ianm8/uSBITX/README.md

# uSBITX
An HF transceiver based on the sBITX.

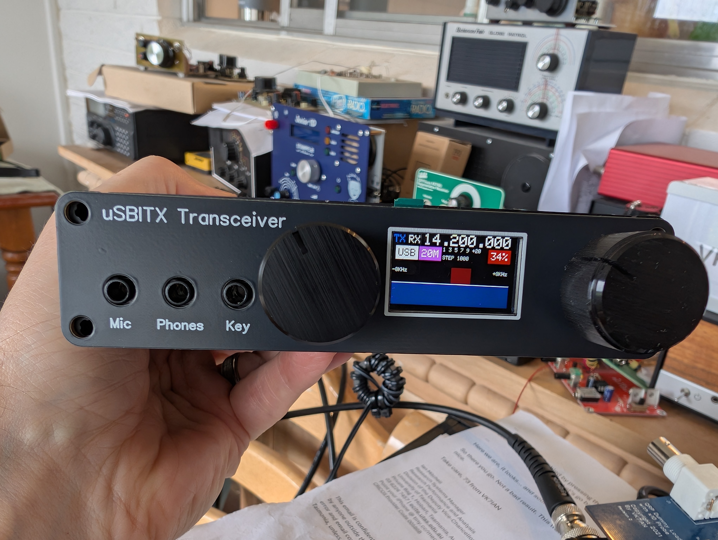
[picture p1: docs/uSBITX-Front.jpg]


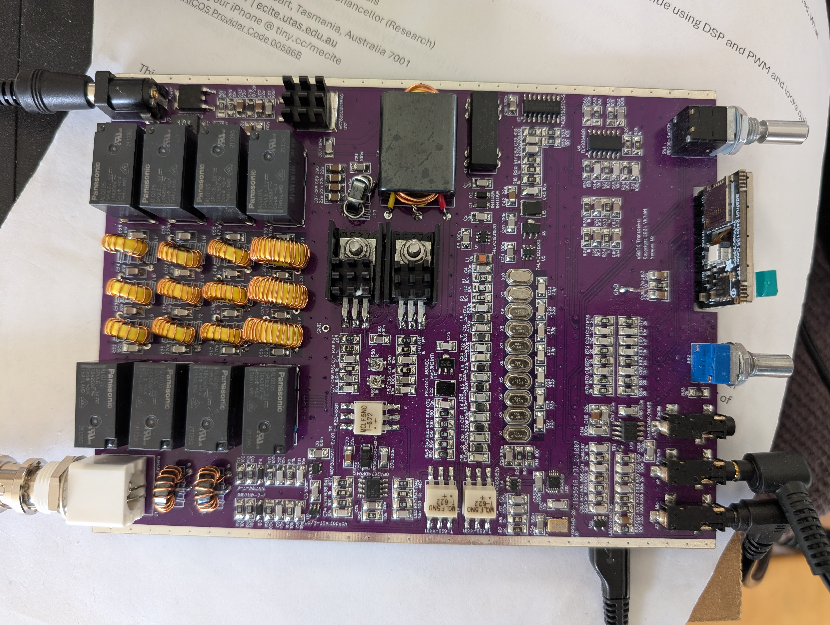
[picture p2: docs/uSBITX Complete.jpg]


Short video of a QSO between VK2IO and VK7AAE
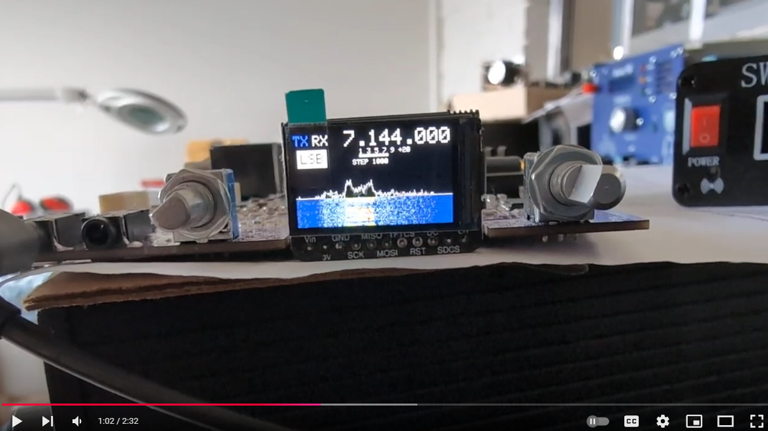
[picture p3: docs/QSO-Video.png]
IMAGE ALT TEXT HERE (https://www.youtube.com/watch?v=36nRCQEVp98&t=1s)


Short video of CW reception
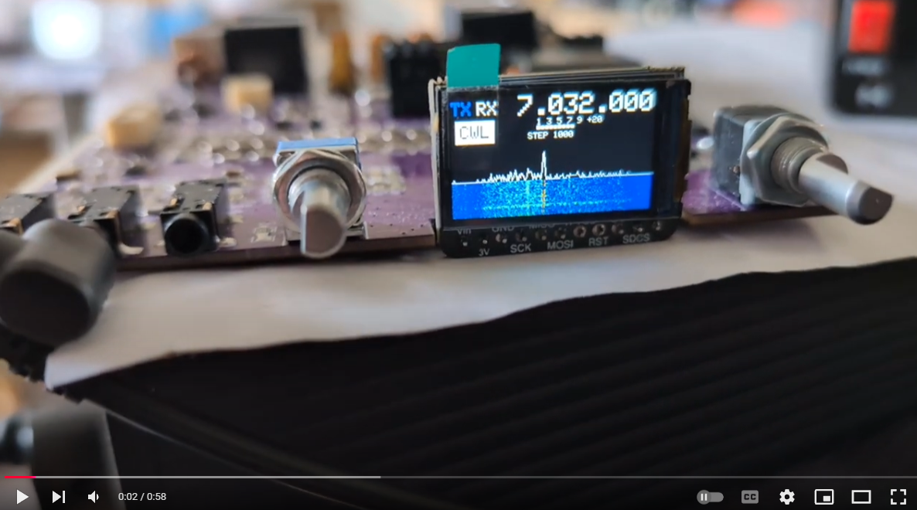
[picture p4: docs/CW-Video.png]
IMAGE ALT TEXT HERE (https://www.youtube.com/watch?v=rOs2oFVajr0)
