ianm8/uSBITX/docs/README.md

# uSBITX Documents
* Version 1.2 adds R86 and R87 for improved SWR and power readings. Also changed U8 to ADL5545ARKZ-R7 which has about 6dB more gain and better noise figure. This improves sensitivity above 15 MHz.
