ianm8/uSBITX/docs/40MHz-Crystal-Filter.jpg

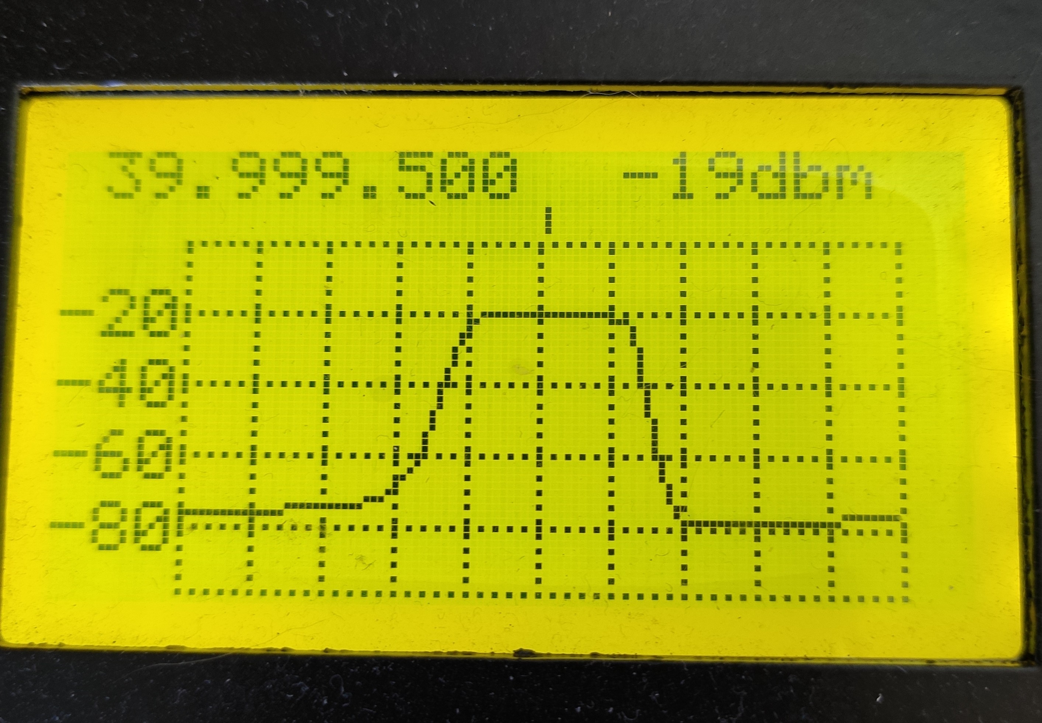
docs/40MHz-Crystal-Filter.jpg
