ianm8/uSBITX/docs/BOM_uSBITX_2025-02-11.csv

ID | Name | Designator | Footprint | Quantity | Manufacturer Part | Manufacturer | Supplier | Supplier Part
1 | 10n | C1,C2,C8,C9,C10,C11,C44,C45,C52,C55,C61,C71,C74,C75,C76,C77,C80,C82,C83,C92,C93,C94,C97,C104,C105,C106 | 1206 | 26
2 | 100n | C3,C4,C5,C6,C7,C21,C26,C34,C41,C46,C53,C54,C60,C62,C67,C68,C69,C70,C79,C81,C84,C85,C86,C96,C98,C110,C111,C114,C115,C117,C118,C119,C120 | 1206 | 33
3 | 820p | C12,C14,C56,C59 | 1206 | 4
4 | 470p | C13,C47,C50 | 1206 | 3
5 | 120p | C15,C20,C22,C25 | 1206 | 4
6 | 220p | C16,C17,C18,C19,C23,C24,C35,C38 | 1206 | 8
7 | 33p | C27,C28,C29,C30,C31,C32,C33 | 1206 | 7
8 | 360p | C36,C37 | 1206 | 2
9 | 220n | C39,C43,C103 | 1206 | 3
10 | 22u | C40,C42,C72,C73,C95,C107,C108,C109,C112,C113,C116 | 1206 | 11
11 | 1n | C48,C49,C91 | 1206 | 3
12 | 100p | C51,C78 | 1206 | 2
13 | 1n3 | C57,C58 | 1206 | 2
14 | 3n3 | C63,C64,C65,C66 | 1206 | 4
15 | 22u | C87,C88,C89,C90,C121,C122,C123,C124 | 1206 | 8 |  |  | LCSC | C22367833
16 | 1n5 | C99,C100,C101,C102 | 1206 | 4
17 | 1N4148W | D1,D2 | SOD-123_L2.8-W1.8-LS3.7-RD | 2 | 1N4148W-7-F | DIODES | LCSC | C83528
18 | 1N5711W-7-F | D3,D4 | SOD-123_L2.8-W1.8-LS3.7-RD | 2 | 1N5711W-7-F | Diodes Incorporated | LCSC | C154843
19 | BZG05C3V3-M3-08 | D5 | SMA_L4.3-W2.6-LS5.2-RD | 1 | BZG05C3V3-M3-08 | VISHAY(威世) | LCSC | C467520
20 | SS14 | D6 | SMA_L4.4-W2.8-LS5.4-RD | 1 | SS14 | MDD | LCSC | C2480
21 | Antenna | J1 | BNC_PCB | 1
22 | Mic | J2 | CUI_SJ-3524-SMT | 1 |  |  |  | SJ-3524-SMT
23 | Power | J3 | DC-072-165A | 1 | DC-072-165A | HRO | LCSC | C129003
24 | Phones | J4 | CUI_SJ-3524-SMT | 1 |  |  |  | SJ-3524-SMT
25 | Paddle | J5 | CUI_SJ-3524-SMT | 1 |  |  |  | SJ-3524-SMT
26 | HE721A0500 | K1 | RELAY-TH_HE721A0500 | 1 | HE721A0500 | Littelfuse(美国力特) | LCSC | C151704
27 | ALQ105 | K2,K3,K4,K5,K6,K7,K8,K9 | RELAY-TH_ALQ1XX | 8 | ALQ105 | PANASONIC(松下) | LCSC | C719517
28 | 10u | L1 | 120608 | 1 | AISM-1812-1R0K |  |  | 1206F-100K-01
29 | 330n | L2,L6 | 120608 | 2 | AISM-1812-1R0K |  |  | AISM-1812-1R0K
30 | 390n | L3,L4,L5 | 120608 | 3 | AISM-1812-1R0K |  |  | AISM-1812-1R0K
31 | 2u2 | L7,L8 | 120608 | 2 | AISM-1812-1R0K |  |  | AISM-1812-1R0K
32 | 330n | L9,L11 | T37-6 | 2
33 | 360n | L10 | T37-6 | 1
34 | 560n | L12,L14 | T37-6 | 2
35 | 620n | L13 | T37-6 | 1
36 | PFL4514-153MEC | L15,L22 | PFL4514-SM | 2 | PFL4514 | Coilcraft |  | PFL4514
37 | 580n | L16,L17,L18 | T37-6 | 3
38 | 2u2 | L19,L20,L21 | T37-6 | 3
39 | 5T | L23 | T37-6 | 1 | FT37-43 | FT37-43 |  | FT37-43
40 | RD16HHF1 | Q1,Q2 | TO220 | 2
41 | FQD11P06TM | Q3 | DPAK-3_L6.6-W6.1-P2.28-LS9.9-BR | 1 | FQD11P06TM | ON Semiconductor | LCSC | C719783
42 | 10k | R1,R2,R3,R4,R5,R43,R53,R56,R57,R70,R80,R81,R84 | 1206 | 13 | ?
43 | 1k | R6,R7,R17,R18,R20,R25,R26,R28,R29,R31,R33,R34,R36,R38,R46,R47,R51,R52 | 1206 | 18 | ?
44 | 100k | R8,R13,R24,R64,R66,R67,R73,R85 | 1206 | 8 | ?
45 | 100 | R9,R10,R11,R12,R14,R15,R19,R21,R22,R23,R27,R30,R32,R37,R39,R40,R50,R63 | 1206 | 18 | ?
46 | 10 | R16,R78 | 1206 | 2 | ?
47 | 150 | R35,R44,R45 | 1206 | 3 | ?
48 | 4R7 | R41,R42,R48,R49 | 1206 | 4 | ?
49 | 2k | R54,R55,R60,R61,R62,R65,R68,R69,R71,R72,R74,R75,R76,R77,R83 | 1206 | 15 | ?
50 | 1k | R58,R59 | 35WR1KLFTR | 2 |  |  |  | 35WR1KLFTR
51 | 10/2W | R79 | 1206 | 1 | ?
52 | 10k | R82 | BOURNS_PTD901_1GANG | 1 | PTD901-1015K-B103‎ | Bourns | Mouser | PTD901-1015K-B103‎
53 | PEC09-SWITCH | SW1 | PEC09-SWITCH | 1
54 | FT37_SENSE_TRANSFORMER | T1,T2 | FT37_SENSE_TRANSFORMER | 2
55 | T-622-KK81 | T3,T5,T6 | T-622-KK81-SM | 3
56 | T1T1T3T | T4 | T1T1T3T-FP | 1
57 | PA4339.101 | T7 | PA4339.501NLT FOOTPRINT | 1 | PA4339.101NLT | Pulse Electronics Power | Digi-Key | PA4339.101NLT
58 | 74LVC1G3157D | U1,U4,U5 | SOT-23-6_L2.9-W1.6-P0.95-LS2.8-BR | 3 | SN74LVC1G3157DBVR | TI | LCSC | C10426
59 | MCP3021A0T-E/OT | U2 | SOT-23-5_L2.9-W1.6-P0.95-LS2.8-BR | 1 | MCP3021A0T-E/OT | MICROCHIP(美国微芯) | LCSC | C625465
60 | MCP3021A1T-E/OT | U3 | SOT-23-5_L2.9-W1.6-P0.95-LS2.8-BR | 1 | MCP3021A1T-E/OT | MICROCHIP(美国微芯) | LCSC | C5127749
61 | 74CBT3257C-SOIC | U7 | SOIC-16_L9.9-W3.9-P1.27-LS6.0-BL | 1 | PI5C3257LEX | PERICOM |  | C94422
62 | MMG3H21NT1 | U8,U12 | SOT-89-3_L4.5-W2.5-P1.50-LS4.2-BR | 2 | MMG3H21NT1 | NXP |  | C2151398
63 | FOX914B-26 | U9 | FOX924B | 1 | FOX924B-25 | Fox | Mouser | 559-FOX924B-25
64 | MS5351M | U10 | MSOP-10_L3.0-W3.0-P0.50-LS5.0-BL | 1 | MS5351M | 杭州瑞盟 | LCSC | C1509083
65 | TLS850B0TE V50 | U11 | PG-TO252-5_L6.5-W6.3-P1.14-LS10.0-BR | 1 | TLS850B0TE V50 | Infineon(英飞凌) | LCSC | C540294
66 | ULQ2003D1013TR | U14 | SOIC-16_L9.9-W3.9-P1.27-LS6.0-BL | 1 | ULQ2003D1013TR | STMicroelectronics | LCSC | C155642
67 | Raspberry Pi Pico 2 Castellated | U15 | PI_PICO_RP2040 | 1 | Pi Pico | Raspberry Pi Foundation | Raspberry Pi | Pi Pico 2
68 | LMV321SN3T1G | U16 | TSOP-5_L3.0-W1.5-P0.95-BL | 1 | LMV321SN3T1G | onsemi(安森美) | LCSC | C84726
69 | MC7805CD2TR4G | U17 | TO-263-2_L10.0-W9.1-P5.08-LS15.2-TL | 1
70 | LCD | U18 | LCD4383SM | 1 |  | null | Mouser | 485-4383
71 | LM4875MX/NOPB | U19 | SOIC-8 | 1 | LM4875MX/NOPB | TI | LCSC | C134135
72 | 40MHz | X1,X2,X3,X4,X5,X6,X7,X8,X9,X10 | CRYSTAL-SMALL | 10 | ECS-400-20-46X | ECS | Mouser | 520-400-20-46X
73 | TLV9364IDR | U6 | SOIC-14_L8.7-W3.9-P1.27-LS6.0-BL | 1 | TLV9364IDR | TI(德州仪器) | LCSC | C4368844
74 | OPA2674IDRG4 | U13 | SOIC-8_L4.9-W3.9-P1.27-LS6.0-BL | 1 | OPA2674IDRG4 | TI(德州仪器) | LCSC | C2060106
