ianm8/uSBITX/(threads)

Thread 1 (2025-02-11):

About the screen model

Trendyfu, 2025-02-11:
Hello，Ian
I admire you for creating this transceiver with Raspberry Pi PI PICO2. You have done a good job. Because the BOM is not provided in the project, I would like to inquire about the screen model you use in this project and the purchase link. At the same time, I hope you can provide the BOM information. Thanks.
73

ianm8, 2025-02-11:
Hi Trendy

Thanks for the reminder. I just uploaded the Gerbers and BOM. I got the display from Adafruit, part number 4383: https://www.adafruit.com/product/4383

You can also get them from Mouser and Digikey. eg Mouser: 485-4383

A note on the BOM.

* all capacitors are C0G except the 22uF caps
* for the surface mount inductors I found ones with as high an SRF as possible
* the pads for SM inductors are sized to take 0805 or 1206 (in case 1206 aren't available)

73, Ian

Trendyfu, 2025-02-11:
Hello，Ian

Thanks for your reply.

This screen is much smaller than I expected. Can you tell me why you chose the Raspberry Pi PICO2 as the main control chip instead of the ESP32? It's amazing that you have implemented the waterfall function on such a small screen.
Also, do you have any follow-up plans for this project? For example, add power adjustment function, add automatic antenna tuning function, or increase the screen size, etc.?

Thanks again.
73, Trendy

ianm8, 2025-02-11:
Hi Trendy

I'm not very familiar with the ESP32. I used the Pico 2 mostly because I am familiar with it and it has an M33 with floating point. I found doing DSP with floating point produced much better sound quality. Also the Pico 2 is great value for the price.

Power can be adjusted using the mic gain function. There really isn't space for an antenna tuner - or maybe there is on another board if it fits in the case. The screen size is small in order for it fit in the Hammond case I chose for the project.

73, Ian

Trendyfu, 2025-02-11:
Hi Ian

Glad to receive your reply again.
I think I understand exactly what you mean. For the screen size, I think the screen specification can be replaced by modifying the code, but it seems a bit complicated. Is it right?

I didn't find your relevant video about the operation logic and setting interface of uSBITX on your youtube channel. I wonder if you will consider a detailed introduction in the future?
I'm very curious about how such a small color screen can perform the transceiver setup operation.

Looking forward to your reply, thank you.
73, Trendy

ianm8, 2025-02-11:
Hi Trendy

I will try and do another video explaining operation. In the meantime, if you have a look a the menu.h file here: https://github.com/ianm8/uSBITX/blob/main/src/V3/menu.h you can get an idea of the menus and associated options. Happy to answer any questions.

73, Ian

Trendyfu, 2025-02-11:
Hi Ian
Thank you for replying to me so happily.

I think I found the menu you're talking about, as follows
"Enum menu_top_t
{
MENU_BAND,
MENU_STEP,
MENU_MODE,
MENU_CW_SPEED,
MENU_SIDETONE,
MENU_SIDETONE_LEVEL,
MENU_IFSHIFT,
MENU_SPECTRUM_TYPE,
MENU_JNR,
MENU_MIC,
MENU_GAUSSIAN,
MENU_EXIT
}; "

I would also like to ask you, for the PA part, you did not use CLASS class E amplifier, but used CLASS AB, right? I would like to ask the reason for this, because I am a new HAM and do not know much about this.

You're right. The uSBITX transceiver may be able to expand the ATU's capabilities with an additional antenna tuning board, but this requires software support and may be a future feature.

Overall, I think the work you are currently doing is excellent, and I look forward to seeing this project continue to improve.

73, Trendy

ianm8, 2025-02-11:
Yeah, class AB push-pull operates as a linear amplifier. You feed it the signal you want to amplify and it is supposed to amplify it without distortion. A push-pull arrangement means there is less second order harmonic distortion so only four output filters are needed.

A class E amplifier is essentially a high-speed switch connected to a tuned circuit. You need to feed it the frequency and amplitude separately for SSB. For FM you only need to change the frequency. It is efficient but you need a tuned circuit for each band.

Of course you can find details about this online. My decision to use a linear amplifier rather than a cless-e amp is because it is easier and cheaper in both hardware and software. Also I currently consider class e design beyond my capability. Class AB is less power efficient but I'm really not that fussed about power efficiency in a QRP radio.

ianm8, 2025-02-12:
Yeah, about 20 watts on 40m and falls to about 5 on 10m.

Trendyfu, 2025-02-12:
Thank you, Ian

When I have free time, I will try to build this interesting little transceiver myself, during which I need to learn more about electronics.

I wish this project better and better, and look forward to keeping in touch with you.

73, Trendy

Closed 2025-02-12.

Thread 2 (2025-02-15):

Some questions and suggestions

Trendy73, 2025-02-15:
Hi Ian
Recently I was studying the schematics of uSBITX and encountered the following questions. I would like to ask you to answer them for me.

1. In the schematics, the signal is mixed twice when receiving. The first time is the mixer composed of U4 74LVC1G3157D and T-622-KK81, which seems to be called a passive FET mixer, right? The second time is the intermediate frequency mixing by U7 74CBT3257C. Can you introduce to me the principle of 74CBT3257C mixing? In the original sBITX, the author should use diode double-balanced mixing.

2. For LO and BFO, what are their frequencies respectively?

3. T-622-KK81 is a bit expensive. Can I use BN43-1502 or BN43-2402 magnetic ring to wind a certain number of turns in three wires to replace it? In sBITX, it seems that FT37-43 magnetic ring is used for winding, but I can't find how many turns should be wound.

Some suggestions

1. The RX and TX icons are displayed on the screen at the same time. Can their positions be overlapped? Display RX when receiving and TX when transmitting, which should save some space on the screen.

2. uSBITX has a small number of components and is suitable for being made into a portable machine, just like zBITX, which can have a built-in battery. So have you considered adding a battery display option to uSBITX? Use the saved RX/TX icon position for input voltage display or battery power display.

I look forward to your reply and hope I won't bother you.
73, Trendy

ianm8, 2025-02-15:
HI Trendy

Thanks for the good questions.

1. Yes. It is also half an H-mode mixer. It works by alternatively grounding each size of the transformer so the output is switching the input by 180 degrees at the oscillator frequency. The second mixer is a sampling detector. Basically the signal is sampled and stored in the capacitors. It is essentially half a Tayloe detector. They are great for mixing to baseband. Unlike a diode mixer where each port must see a 50 ohm impedance, the sampling detector actually presents a 50 ohm impedance at its input. There is little attention to, better large signal handling, and the oscillator input is perfectly suited to the output of the SI5351 since it only needs a 3V CMOS signal.

2. It is an up-conversion radio. The IF is at 40 MHz. So the LO is set to the tuned frequency plus the IF (the centre of the IF). The BFO is set to the centre of the IF plus 7812 Hz. This puts the centre of the signal at a quarter of the sampling frequency which is the middle of the passband.

3. You could substitute a 78602/4JC (pulse transformer) or wind 8 trifilar turns on an FT37-43. I did a few tests of the 78602/4JC and it should be fine but I've not used it in this project.

Your suggestions are interesting. Anyone can make changes to the UI. To display the battery voltage I would suggest using another I2C ADC with its input connected to a resistor divider so that the maximum voltage does not exceed 3.3V.

Cheers, Ian

Trendyfu, 2025-02-16:
Hi Ian
I am very happy to receive your reply again.

For a novice, the concept of mixing is still a bit too difficult, but your patient answer has pointed me in the right direction.
After receiving your reply, I looked up some information on the Internet, but I still didn't understand it. I would like to ask you to answer the following questions for me.

1. According to you, after the first mixing, we should get the IF carrying the audio signal, right? After passing through the 40M crystal filter, the IF carrying the audio signal is filtered out.
For the second mixing, do we need to strip the audio signal from the IF? So that the audio signal can be sent to PICO2 for processing?

2. For the main control chip, have you considered PICO2 W (with WIFI function)? Perhaps WIFI can enrich the gameplay of sBITX transceiver, such as connecting to FT8CN APP, etc. I am just talking nonsense, I like brainstorming, hehe.

For the replacement of T-622-KK81, I will try it according to your suggestions later, thank you.

For the addition of voltage display, I think INA226 chip can be used. I have seen it in other circuits. It is very small and supports I2C.

You are right. uSBITX provides source code. Anyone can modify the UI according to their own ideas. However, I have no software programming foundation. If I want to compile the code, I still have a long way to go.

Amateur radio is a new field for me. Anyway, I really appreciate your patience in answering so many questions for me.

Cheers, Trendy

ianm8, 2025-02-16:
Hi Trendy

1. Not really. Technically there are two IF frequencies that are carrying the audio but are not at audio frequencies. The first IF is at 40MHz with a bandwidth of about 15KHz - the audio signals are still modulated at 40MHz though. The second IF is at 7812Hz which is in the audio band but is still not the actual audio yet. The audio is centred around 7812Hz. For example, say you want to tune to a 7.1MHz LSB signal in the 40m band. The LO will be set to 47.1 MHz (40MHz + 7.1MHz). Now the signal from the first mixer appears at 54.2MHz (47.1 + 7.1) and 40MHz (47.1 - 7.1). The 40MHz crystal filter selects the latter signal at 40MHz. The BFO is set to 40,007,812 Hz and now the output of the second mixer will have signals at 80,007,812 Hz (40,007,812 + 40,000,000) and 7812 Hz (40,007,812 - 40,000,000). The former signal is filtered out leaving the signal at 7812Hz. This signal is sampled at the ADC sample rate of 31250 Hz. The DSP now extracts the LSB with a low-pass filter at 7812Hz then shifts the signal down to actual audio with a digital mixer at 7812Hz. Then a final filter is applied with a range of 300-2400 Hz. Note that 7812Hz is a quarter of the sample rate which means there are significant optimisations that can be applied because sin and cos values reduce to 0, 1, and -1 at that frequency. Eg the FIR filters operate twice as fast (for the same number of taps) and the mixer reduces to a simple multiplexer rather than needing to multiply with a sin or cos value.

2. That is an interesting idea. It may also be possible to run FT8 standalone on the Pico 2. That would need a lot of effort to get going though!

3. Another good idea! I think the INA219 would be another option because there are Arduino libraries for it and it comes in an SOIC8 package.

Cheers, Ian

ianm8, 2025-02-17:
Hi Trendy

It is a pleasure to answer your questions. I enjoy designing and building my own equipment but I also publish them so that others can hopefully benefit and maybe even be inspired to try homebrew.

The second mixer is a sampling detector. This means it has intrinsic low-pass filtering. The cut-off frequency is about 80 Khz. That is based on the 100 Ohm resistors and 10 nF capacitors (R21, R27, C44, C55). Cut-off is therefore F = 1 / (2 * Pi * 100 * 2 * 10nF). There is an extra 2 because the switches are each on 50% of the time so the resistance is doubled. So RF is filtered out. That leaves just the low frequencies which will range up to 15KHz which is determined from the bandwidth of the crystal filter. There are a further two low-pass filters, one in the op amp (R24, C51) and the other RC network R31, C61. Each of these has a cut-off of about 16 KHz. So all the RF is removed and we're left with an audio signal with a 15KHz bandwidth. Since the sample rate is 31250 Hz we should not present a signal of more the half that to the ADC (this is the Nyquist theorem). The signal we are interested in processing is centred at 7812 Hz. The DSP in the Pico2 does the job as I described above. That is (for LSB, SSB): Low-pass @ 7812 Hz -> mixer @ 7812 Hz -> band-pass @ 300-2400 Hz -> AGC -> PWM -> Audio.

These DSP stages do the following:
1. Low-pass @ 7812 Hz - removes the USB leaving the LSB
2. mixer @ 7812 Hz - moves the signal at 7812 Hz down to zero (ie base-band)
3. band-pass @ 300-2400 - removes any images from mixing and sets the audio bandwidth
4. AGC - stabilises the gain and sets the maximum value for the PWM (ie +2047, -2048)
5. PWM - is 12 bits and runs at 55 KHz (225,000,000 / 4096) - there is a filter starting with R60 to remove the high-speed switching from the PWM leaving just the audio

Cheers, Ian

Trendyfu, 2025-02-17:
Hi Ian

I am very happy to receive your reply again. You know, your detailed answer is like explaining it to me face to face. I have now preliminarily understood the mixing and filtering principles of uSBITX.

However, I think I have encountered a few more problems.

1. I think D5 in the schematic diagram, which is the BZG05C3V3-M3-08 voltage regulator diode, should be wrong. Its applicable voltage is 3.3 volts, but it is all at 12 volts. Should it be BZG05C13-M3-08 or BZG05C15-M3-08?

2. For the D1 and D2 (1N4148W) diodes, what is their role here? In my fixed mindset, I think D2 shorts the transmission path to ground, hehe.

3. In addition, for U1 74LVC1G3157D, what is the role of connecting 5 volts to pin 4 (port A)? For U9 TCXO, if I use another brand of TCXO, are there any requirements for selection?

In your previous reply, I think your design of 55 KHz band-stop filter is excellent, which is a great idea.

I didn't expect that this seemingly not complicated schematic diagram contains so much knowledge. I have studied signals and systems and communication principles before, but as time goes by, I have long forgotten these knowledge, although I didn't learn them well at that time. You are like a teacher, bringing me back to my student days.

Amateur radio is really a complicated and interesting thing.

Cheers, Trendy

ianm8, 2025-02-17:
Hi Trendy

Thank you for your questions.

1. The 3.3V zener diode is in series with the 12V supply so that it drops the voltage by 3.3V to below 10V. This is the maximum voltage that the OPA2674 (U13) should be supplied with.

3. D1 and D2 have a forward voltage drop of about 600mV to 700mV. They will not conduct until this threshold voltage is exceeded. Because the diodes are "back-to-back" any RF voltage exceeding about 1.2V PP will be shunted to ground. They are therefore there to provide protection from large signals that might damage the following circuits. This might be from nearby transmitters or a software issue where the receive relay is accidentally engaged during transmit!

4. Even though U1 is an analogue multiplexer it does not respond to signals outside of the power supply voltage range. So the RF signal must be restricted to between 0V and 3V. Resistors R1, R2 and R3 form a voltage divider that applies a bias of about 1.6V to port A of U1. L1 forms a high impedance to RF but allows DC through. Thus the RF signal is not impeded although the DC bias is applied.

Hope this helps, cheers, Ian

Trendy73, 2025-02-18:
Sorry, Ian

Fixed thinking limits me, I forgot that the diode also has the effect of lowering blood pressure. Thank you for your answer. This is very helpful to me, and my understanding of uSBITX has been further advanced.

In addition, I noticed that in the transmission path, there seems to be a Pi-type attenuator after the U12 MG3H21NT1. Is this to attenuate the strength of the transmitted signal?

Another question, what is the function of the Q3 FQD11P06TM P-channel FET? Excuse my ignorance.

Cheers, Trendy

ianm8, 2025-02-18:
Hi Trendy

I added an attenuator there because my calculations showed there would be too much gain for the power mosfets. I could have used a different MMIC but I like to have as few different component types as possible.

The P-type MOSFET is for reverse polarity protection. When normal power is applied the body diode conducts and sets the gate negative with respect to the source which turns the transistor on. With reverse voltage the gate is positive with respect to the source and the transistor stays off. The on resistance is very low so there is very little voltage drop across it.

I hope your blood pressure stays low!

Cheers, Ian

Trendy73, 2025-02-18:
Haha, Ian, this is actually a mistake, what I'm trying to say is that diodes lower voltage, not blood pressure. Thanks for your humorous reply.

I have come to an end to this issue. Thank you for your patience in answering these days. I will take the time to continue learning about amateur radio. If I encounter problems in my study in the future, I think maybe I can contact you by email.

Anyway, it was a really pleasant exchange, thanks again.

Cheers, Trendy

ianm8, 2025-02-18:
No probs Trendy. Good luck!
73, Ian
VK7IAN

Closed 2025-02-18.
