ianm8/uSBITX/docs/Schematic_uSBITX_2025-06-23.pdf

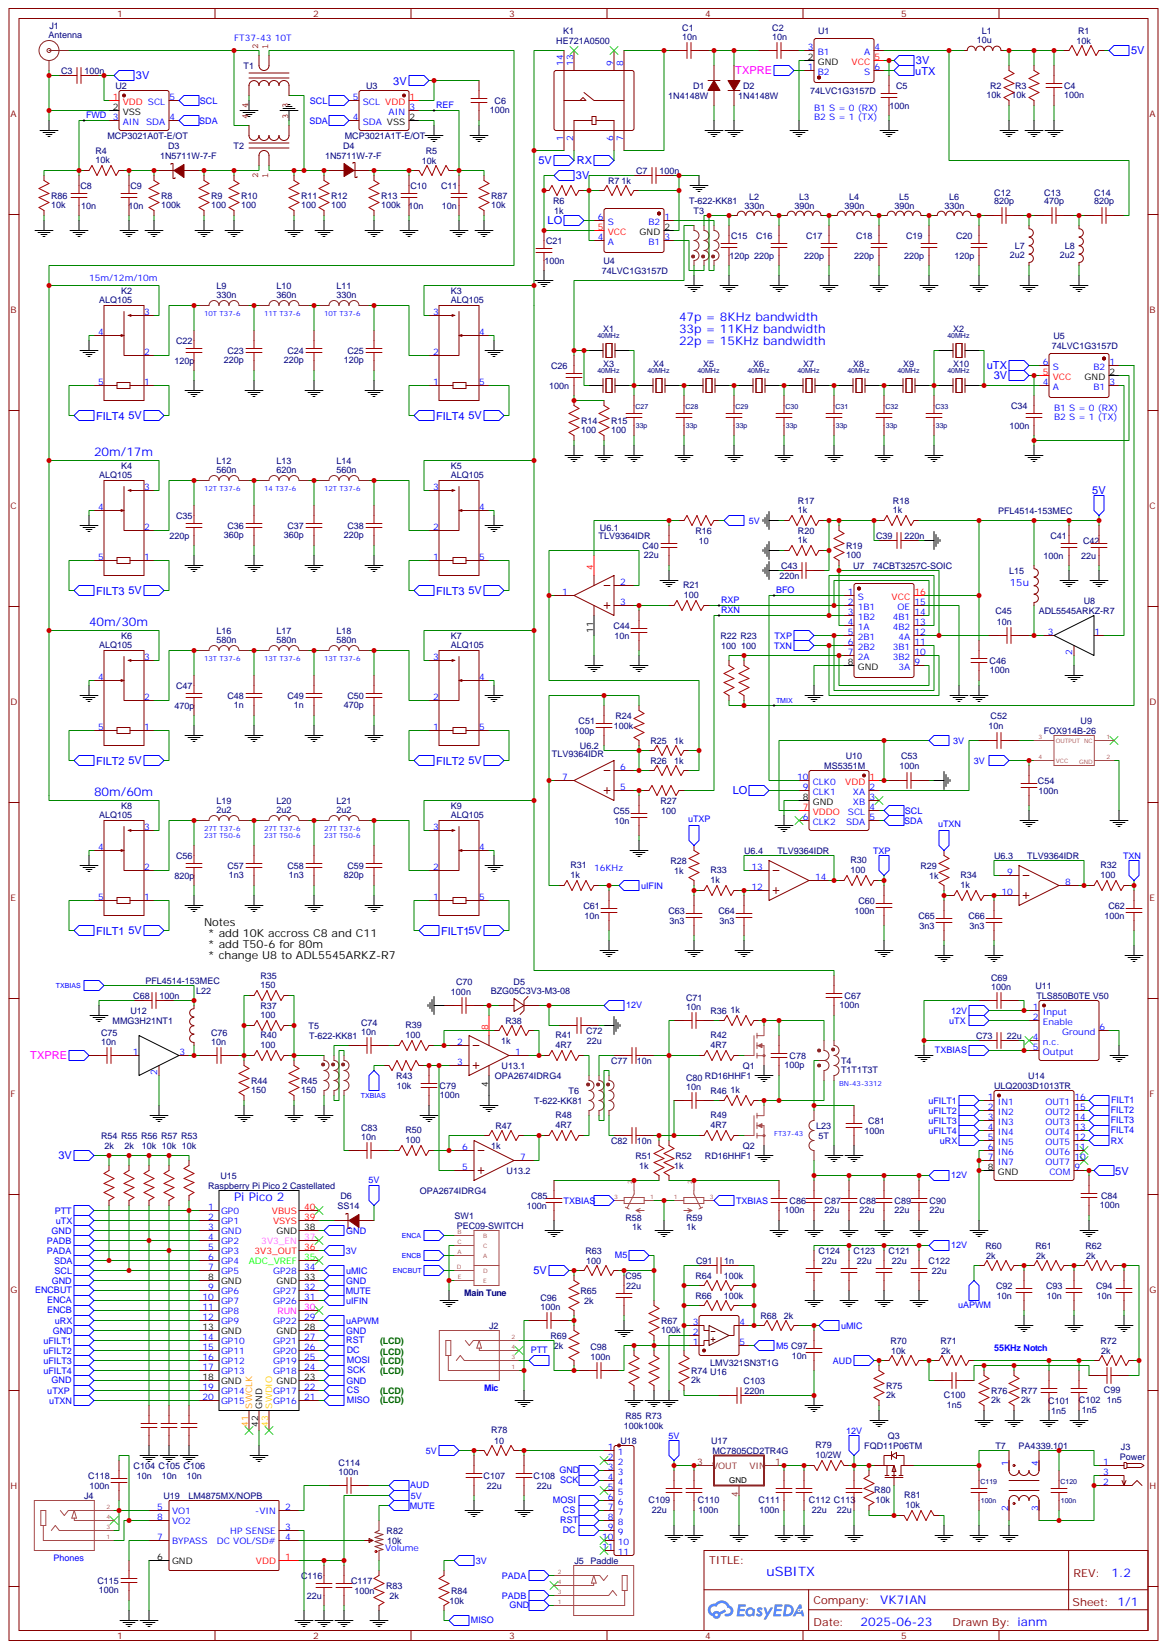
[picture p7: page 1]

Raspberry Pi Pico 2 Castellated

GP3 5
GP5 7
