ianm8/uSBITX/docs/Schematic_uSBITX_2024-11-08.pdf

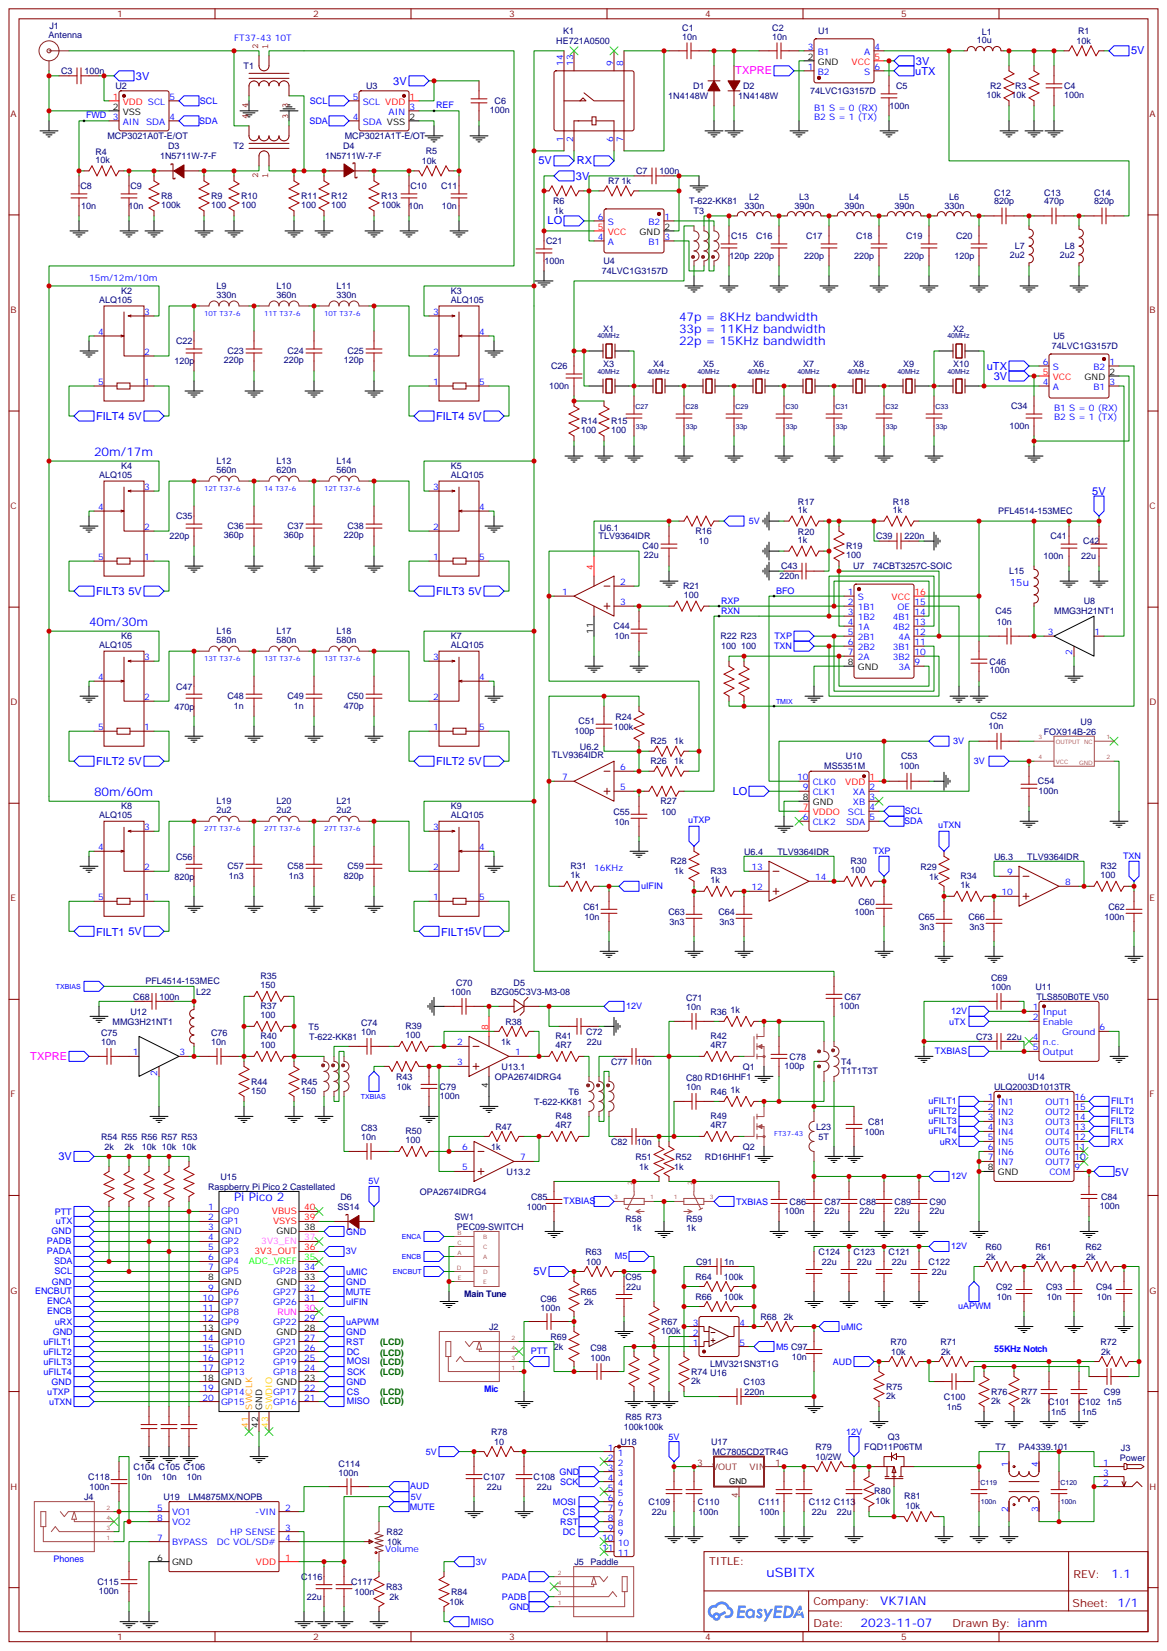
[picture p8: page 1]

Raspberry Pi Pico 2 Castellated

GP1 2
GND 3
GP3 5
GP4 6
GP5 7
GND 8
