ianm8/uSBITX/src/V3/filters.h

#ifndef FILTERS_H
#define FILTERS_H

#include "util.h"

#define MOVING_AVERAGE_LENGTH 16u
#define JNR_FILTER_LENGTH 8u
#define FIR_LENGTH 256
#define __mac_tap(_h) acc += (_h)*x[i++]
#define __mac_zap(_h) i++

namespace FILTER
{
  static const float __not_in_flash_func(bpf_300_3000f_rx)(const float sample)
  {
    // 31250, 60dB, 300Hz - 4000Hz, 255 taps
    static float x[FIR_LENGTH] = { 0 };
    static uint8_t sample_index = 0;
    uint8_t i = sample_index;
    x[sample_index--] = sample;
    float acc = 0.0f;
    __mac_tap(0.000023f);
    __mac_tap(0.000009f);
    __mac_tap(-0.000039f);
    __mac_tap(-0.000098f);
    __mac_tap(-0.000133f);
    __mac_tap(-0.000119f);
    __mac_tap(-0.000058f);
    __mac_tap(0.000012f);
    __mac_tap(0.000038f);
    __mac_tap(-0.000012f);
    __mac_tap(-0.000125f);
    __mac_tap(-0.000244f);
    __mac_tap(-0.000296f);
    __mac_tap(-0.000241f);
    __mac_tap(-0.000108f);
    __mac_tap(0.000017f);
    __mac_tap(0.000041f);
    __mac_tap(-0.00008f);
    __mac_tap(-0.000298f);
    __mac_tap(-0.000494f);
    __mac_tap(-0.000546f);
    __mac_tap(-0.000413f);
    __mac_tap(-0.000171f);
    __mac_tap(0.000021f);
    __mac_tap(0.000015f);
    __mac_tap(-0.000228f);
    __mac_tap(-0.000595f);
    __mac_tap(-0.000877f);
    __mac_tap(-0.000899f);
    __mac_tap(-0.000633f);
    __mac_tap(-0.000238f);
    __mac_tap(0.000021f);
    __mac_tap(-0.000062f);
    __mac_tap(-0.000493f);
    __mac_tap(-0.001055f);
    __mac_tap(-0.001421f);
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
    __mac_tap(0.006812f);
    __mac_zap(0.0f);
    __mac_tap(-0.004686f);
    __mac_tap(-0.00543f);
    __mac_tap(-0.003115f);
    __mac_zap(0.0f);
    __mac_tap(0.001975f);
    __mac_tap(0.002171f);
    __mac_tap(0.00117f);
    __mac_zap(0.0f);
    __mac_tap(-0.000626f);
    __mac_tap(-0.00061f);
    __mac_tap(-0.000279f);
    __mac_zap(0.0f);
    return acc;
  }

  static float __not_in_flash_func(dcf)(const float in)
  {
    // single pole IIR high-pass filter
    //static const float k = 0.004f; // <100Hz
    //static const float k = 0.01f; // ~100Hz
    //static const float k = 0.1f; // ~300Hz
    static const float k = 0.05f; // ~200Hz
    static float s = 0;
    static float x1 = 0;
    static float y1 = 0;
    s -= x1;
    x1 = in;
    s += x1 - y1 * k;
    return (y1 = s);
  }

  static const float __not_in_flash_func(maf1)(const float v)
  {
    static float element[MOVING_AVERAGE_LENGTH] = {0.0f};
    static uint8_t p = 0;
    static float sum = 0.0f;
    sum = sum - element[p] + v;
    element[p++] = v;
    p &= (MOVING_AVERAGE_LENGTH-1);
    return sum / ((float)MOVING_AVERAGE_LENGTH);
  }

  static const float __not_in_flash_func(maf2)(const float v)
  {
    static float element[MOVING_AVERAGE_LENGTH] = {0.0f};
    static uint8_t p = 0;
    static float sum = 0.0f;
    sum = sum - element[p] + v;
    element[p++] = v;
    p &= (MOVING_AVERAGE_LENGTH-1);
    return sum / ((float)MOVING_AVERAGE_LENGTH);
  }

  static const float __not_in_flash_func(maf3)(const float v)
  {
    static float element[MOVING_AVERAGE_LENGTH] = {0.0f};
    static uint8_t p = 0;
    static float sum = 0.0f;
    sum = sum - element[p] + v;
    element[p++] = v;
    p &= (MOVING_AVERAGE_LENGTH-1);
    return sum / ((float)MOVING_AVERAGE_LENGTH);
  }

  static const float __not_in_flash_func(maf4)(const float v)
  {
    static float element[MOVING_AVERAGE_LENGTH] = {0.0f};
    static uint8_t p = 0;
    static float sum = 0.0f;
    sum = sum - element[p] + v;
    element[p++] = v;
    p &= (MOVING_AVERAGE_LENGTH-1);
    return sum / ((float)MOVING_AVERAGE_LENGTH);
  }

  static const float __not_in_flash_func(ma_order_4)(const float s)
  {
    return maf4(FILTER::maf3(FILTER::maf2(FILTER::maf1(s))));
  }

  static const int16_t __not_in_flash_func(jnr_maf1)(const int16_t v)
  {
    static int16_t element[JNR_FILTER_LENGTH] = {0};
    static uint8_t p = 0;
    static int32_t sum = 0;
    sum = sum - element[p] + v;
    element[p++] = v;
    p &= (JNR_FILTER_LENGTH-1);
    return sum/JNR_FILTER_LENGTH;
  }

  static const int16_t __not_in_flash_func(jnr_maf2)(const int16_t v)
  {
    static int16_t element[JNR_FILTER_LENGTH] = {0};
    static uint8_t p = 0;
    static int32_t sum = 0;
    sum = sum - element[p] + v;
    element[p++] = v;
    p &= (JNR_FILTER_LENGTH-1);
    return sum/JNR_FILTER_LENGTH;
  }

  static const int16_t __not_in_flash_func(jnr_maf3)(const int16_t v)
  {
    static int16_t element[JNR_FILTER_LENGTH] = {0};
    static uint8_t p = 0;
    static int32_t sum = 0;
    sum = sum - element[p] + v;
    element[p++] = v;
    p &= (JNR_FILTER_LENGTH-1);
    return sum/JNR_FILTER_LENGTH;
  }

  static const int16_t __not_in_flash_func(jnr_maf4)(const int16_t v)
  {
    static int16_t element[JNR_FILTER_LENGTH] = {0};
    static uint8_t p = 0;
    static int32_t sum = 0;
    sum = sum - element[p] + v;
    element[p++] = v;
    p &= (JNR_FILTER_LENGTH-1);
    return sum/JNR_FILTER_LENGTH;
  }

  static const float __not_in_flash_func(fap1f)(const float s)
  {
    // all pass 84 @ 31250
    // all pass 607 @ 31250
    // all pass 2539 @ 31250
    static const float k1 = 0.98325f;
    static const float k2 = 0.88497f;
    static const float k3 = 0.59331f;
    static float x1 = 0.0f;
    static float y1 = 0.0f;
    static float x2 = 0.0f;
    static float y2 = 0.0f;
    static float x3 = 0.0f;
    static float y3 = 0.0f;
    y1 = (k1 * (s + y1)) - x1;
    x1 = s;
    y2 = (k2 * (y1 + y2)) - x2;
    x2 = y1;
    y3 = (k3 * (y2 + y3)) - x3;
    x3 = y2;
    return y3;
  }

  static const float __not_in_flash_func(fap2f)(const float s)
  {
    // all pass 8628 @ 31250
    // all pass 1200 @ 31250
    // all pass 287 @ 31250
    static const float k1 = 0.07102f;
    static const float k2 = 0.78470f;
    static const float k3 = 0.94391f;
    static float x1 = 0.0f;
    static float y1 = 0.0f;
    static float x2 = 0.0f;
    static float y2 = 0.0f;
    static float x3 = 0.0f;
    static float y3 = 0.0f;
    y1 = (k1 * (s + y1)) - x1;
    x1 = s;
    y2 = (k2 * (y1 + y2)) - x2;
    x2 = y1;
    y3 = (k3 * (y2 + y3)) - x3;
    x3 = y2;
    return y3;
  }
}

#endif
