ianm8/uSBITX/src/V3/spectrum.h

#ifndef SPECTRUM_H
#define SPECTRUM_H

#include "util.h"

#define N_WAVE      1024    /* full length of sinewave[] */
#define LOG2_N_WAVE 10      /* log2(N_WAVE) */

namespace spectrum
{
  static const uint16_t color_map_32[32] =
  {
    0x8000u,
    0xA000u,
    0xF800u,
    0xFA00u,
    0xFC00u,
    0xFE00u,
    0xF800u,
    0xFA00u,
    0x2FC0u,
    0xFFC0u,
    0xCFC0u,
    0x9FC0u,
    0x6FC0u,
    0x3FC0u,
    0x0FC0u,
    0x0FC6u,
    0x0FCCu,
    0x0FD2u,
    0x0FD8u,
    0x0FDEu,
    0x0E1Fu,
    0x0C1Fu,
    0x0A1Fu,
    0x081Fu,
    0x061Fu,
    0x041Fu,
    0x021Fu,
    0x001Fu
  };

  static const int16_t Sinewave[N_WAVE-N_WAVE/4] =
  {
       0,    201,    402,    603,    804,   1005,   1206,   1406,
    1607,   1808,   2009,   2209,   2410,   2610,   2811,   3011,
    3211,   3411,   3611,   3811,   4011,   4210,   4409,   4608,
    4807,   5006,   5205,   5403,   5601,   5799,   5997,   6195,
    6392,   6589,   6786,   6982,   7179,   7375,   7571,   7766,
    7961,   8156,   8351,   8545,   8739,   8932,   9126,   9319,
    9511,   9703,   9895,  10087,  10278,  10469,  10659,  10849,
    11038,  11227,  11416,  11604,  11792,  11980,  12166,  12353,
    12539,  12724,  12909,  13094,  13278,  13462,  13645,  13827,
    14009,  14191,  14372,  14552,  14732,  14911,  15090,  15268,
    15446,  15623,  15799,  15975,  16150,  16325,  16499,  16672,
    16845,  17017,  17189,  17360,  17530,  17699,  17868,  18036,
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
    22589, 22682, 22775, 22867, 22959, 23051, 23143, 23235, 23326, 23417, 23508,
    23598, 23688, 23778, 23868, 23957, 24046, 24135, 24224, 24312, 24400, 24487,
    24575, 24662, 24748, 24835, 24921, 25007, 25092, 25177, 25262, 25346, 25430,
    25514, 25597, 25680, 25763, 25845, 25927, 26009, 26090, 26171, 26252, 26332,
    26411, 26491, 26570, 26648, 26727, 26805, 26882, 26959, 27036, 27112, 27188,
    27263, 27338, 27413, 27487, 27561, 27634, 27707, 27780, 27852, 27923, 27995,
    28065, 28136, 28206, 28275, 28344, 28412, 28481, 28548, 28615, 28682, 28748,
    28814, 28879, 28944, 29009, 29073, 29136, 29199, 29261, 29323, 29385, 29446,
    29506, 29566, 29626, 29685, 29743, 29801, 29859, 29916, 29972, 30028, 30083,
    30138, 30193, 30247, 30300, 30353, 30405, 30457, 30508, 30559, 30609, 30659,
    30708, 30756, 30804, 30852, 30899, 30945, 30991, 31036, 31081, 31125, 31169,
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
  };

  static const uint8_t log32(const uint32_t l)
  {
    // return a 5 bit log value
    if (l>4095) return 0x1fu;
    static const uint8_t logtab32[4096] = 
    {
      0x00u,
      0x00u,
      0x03u,
      0x05u,
      0x07u,
      0x08u,
      0x09u,
      0x0au,
      0x0au,
      0x0bu,
      0x0cu,
      0x0cu,
      0x0cu,
      0x0du,
      0x0du,
      0x0eu,
      0x0eu,
      0x0eu,
      0x0fu,
      0x0fu,
      0x0fu,
      0x0fu,
      0x10u,
      0x10u,
      0x10u,
      0x10u,
      0x10u,
      0x11u,
      0x11u,
      0x11u,
      0x11u,
      0x11u,
      0x12u,
      0x12u,
      0x12u,
      0x12u,
      0x12u,
      0x12u,
      0x12u,
      0x13u,
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
    };
    return logtab32[l];
  }

  /*
    FIX_MPY() - fixed-point multiplication & scaling.
    Substitute inline assembly for hardware-specific
    optimization suited to a particluar DSP processor.
    Scaling ensures that result remains 16-bit.
  */
  inline int16_t FIX_MPY(int16_t a, int16_t b)
  {
    /* shift right one less bit (i.e. 15-1) */
    int32_t c = ((int32_t)a * (int32_t)b) >> 14;
    /* last bit shifted out = rounding-bit */
    b = c & 0x01;
    /* last shift + rounding bit */
    a = (c >> 1) + b;
    return a;
  }

  /*
    fix_fft() - perform forward/inverse fast Fourier transform.
    fr[n],fi[n] are real and imaginary arrays, both INPUT AND
    RESULT (in-place FFT), with 0 <= n < 2**m; set inverse to
    0 for forward transform (FFT), or 1 for iFFT.
  */
  static int32_t fix_fft(int16_t fr[], int16_t fi[], int16_t m, const bool inverse=false)
  {
    int32_t mr, nn, i, j, l, k, istep, n, scale, shift;
    int16_t qr, qi, tr, ti, wr, wi;

    n = 1 << m;

    /* max FFT size = N_WAVE */
    if (n > N_WAVE)
      return -1;

    mr = 0;
    nn = n - 1;
    scale = 0;

    /* decimation in time - re-order data */
    for (m=1; m<=nn; ++m)
    {
      l = n;
      do
      {
        l >>= 1;
      } while (mr+l > nn);
      mr = (mr & (l-1)) + l;

      if (mr <= m)
        continue;
      tr = fr[m];
      fr[m] = fr[mr];
      fr[mr] = tr;
      ti = fi[m];
      fi[m] = fi[mr];
      fi[mr] = ti;
    }

    l = 1;
    k = LOG2_N_WAVE-1;
    while (l < n)
    {
      if (inverse)
      {
        /* variable scaling, depending upon data */
        shift = 0;
        for (i=0; i<n; ++i)
        {
          j = fr[i];
          if (j < 0)
            j = -j;
          m = fi[i];
          if (m < 0)
            m = -m;
          if (j > 16383 || m > 16383)
          {
            shift = 1;
            break;
          }
        }
        if (shift) ++scale;
      }
      else
      {
        /*
          fixed scaling, for proper normalization --
          there will be log2(n) passes, so this results
          in an overall factor of 1/n, distributed to
          maximize arithmetic accuracy.
        */
        shift = 1;
      }
      /*
        it may not be obvious, but the shift will be
        performed on each data point exactly once,
        during this pass.
      */
      istep = l << 1;
      for (m=0; m<l; ++m)
      {
        j = m << k;
        /* 0 <= j < N_WAVE/2 */
        wr =  Sinewave[j+N_WAVE/4];
        wi = -Sinewave[j];
        if (inverse)
          wi = -wi;
        if (shift)
        {
          wr >>= 1;
          wi >>= 1;
        }
        for (i=m; i<n; i+=istep)
        {
          j = i + l;
          tr = FIX_MPY(wr,fr[j]) - FIX_MPY(wi,fi[j]);
          ti = FIX_MPY(wr,fi[j]) + FIX_MPY(wi,fr[j]);
          qr = fr[i];
          qi = fi[i];
          if (shift)
          {
            qr >>= 1;
            qi >>= 1;
          }
          fr[j] = qr - tr;
          fi[j] = qi - ti;
          fr[i] = qr + tr;
          fi[i] = qi + ti;
        }
      }
      --k;
      l = istep;
    }
    return scale;
  }

  /*
    fix_fftr() - forward/inverse FFT on array of real numbers.
    Real FFT/iFFT using half-size complex FFT by distributing
    even/odd samples into real/imaginary arrays respectively.
    In order to save data space (i.e. to avoid two arrays, one
    for real, one for imaginary samples), we proceed in the
    following two steps: a) samples are rearranged in the real
    array so that all even samples are in places 0-(N/2-1) and
    all imaginary samples in places (N/2)-(N-1), and b) fix_fft
    is called with fr and fi pointing to index 0 and index N/2
    respectively in the original array. The above guarantees
    that fix_fft "sees" consecutive real samples as alternating
    real and imaginary samples in the complex array.
  */
  int32_t fix_fftr(int16_t f[], int32_t m, const bool inverse)
  {
    int32_t i, N = 1<<(m-1), scale = 0;
    int16_t tt, *fr=f, *fi=&f[N];

    if (inverse)
      scale = fix_fft(fi, fr, m-1, inverse);
    for (i=1; i<N; i+=2) {
      tt = f[N+i-1];
      f[N+i-1] = f[i];
      f[i] = tt;
    }
    if (! inverse)
      scale = fix_fft(fi, fr, m-1, inverse);
    return scale;
  }

  void process(int16_t buffer[],uint8_t mag[])
  {
    int16_t re[N_WAVE] = { 0 };
    int16_t im[N_WAVE] = { 0 };

    // DC removal
    // (get the average and subtract from all samples)
    int32_t dc = 0;
    for (int32_t i = 0; i < N_WAVE; i++)
    {
      dc += buffer[i];
    }
    dc >>= 10;
    uint32_t max_mag = 0;
    for (uint32_t i = 0; i < N_WAVE; i++)
    {
      const int16_t real_value = buffer[i] - (int16_t)dc;
      const uint16_t mag_value = abs(real_value);
      if (mag_value > max_mag)
      {
        max_mag = mag_value;
      }
      re[i] = real_value;
      im[i] = 0;
    }

    // improve the display dynamic range
    uint32_t range_adjust = 0;
    if (max_mag<64)
    {
      range_adjust = 3u;
    }
    else if (max_mag<128)
    {
      range_adjust = 2u;
    }
    else if (max_mag<256)
    {
      range_adjust = 1u;
    }
    // Hann window
    for (uint32_t i = 0; i < N_WAVE; i++)
    {
      const int32_t real_value = (int32_t)re[i] << range_adjust;
      const int32_t w = real_value * (int32_t)window_hanning_1024[i];
      re[i] = (int16_t)(w >> 15);
    }

    // forward, complex FFT
    fix_fft(re, im, LOG2_N_WAVE);

    // magnitude estimate
    for (uint32_t i = 0; i < N_WAVE; i++)
    {
      // magnitude estimate
      const uint16_t m = abs(re[i]);
      const uint16_t n = abs(im[i]);
      mag[i] = log32(((15 * max(m, n))>>4) + ((15 * min(m, n)) >> 5));
    }
  }
}

#endif
