ianm8/uSBITX/src/V3/mcp3021.h

#ifndef MCP3021_H
#define MCP3021_H

#include "Wire.h"

class MCP3021
{
  public:
    void begin(const uint8_t deviceId);
  	void begin(void);
    const uint16_t read(void);
			
  private:		
    static const uint8_t baseAddress = 0b01001000;
    uint8_t _deviceAddress;
};

// device at specified address
void MCP3021::begin(const uint8_t deviceId)
{
  _deviceAddress = (baseAddress|deviceId);
}

// default device at default address
void MCP3021::begin(void)
{
  _deviceAddress = baseAddress|0b00000101;
}

const uint16_t MCP3021::read(void)
{
  // request 2 bytes from MCP3021
  Wire.requestFrom(_deviceAddress, 2);
  if (Wire.available()==2)
  {
    // MSB bits in lower 4 bits of first byte
    // LSB bits in upper 6 bits of second byte
    return ((Wire.read()<<6) | (Wire.read()>>2));
  }
  return 0xffffu;
}

#endif
