ianm8/uSBITX/src/V3/util.h

#ifndef UTIL_H
#define UTIL_H

#define SAMPLERATE 31250ul
#define PRNG_SEED 0x12345678

#define _rev2(x)  ((((x)&1)<<1) | (((x)>>1)&1))
#define _rev4(x)  ((_rev2(x)<<2) | (_rev2((x)>>2)))
#define _rev8(x)  ((_rev4(x)<<4) | (_rev4((x)>>4)))
#define _rev16(x) ((_rev8(x)<<8) | (_rev8((x)>>8)))

#define _rev(x) (uint16_t)(_rev16(x))

#define LCD_BLACK  _rev(TFT_BLACK)
#define LCD_WHITE  _rev(TFT_WHITE)
#define LCD_RED    _rev(TFT_RED)
#define LCD_GREEN  _rev(TFT_GREEN)
#define LCD_BLUE   _rev(TFT_BLUE)
#define LCD_YELLOW _rev(TFT_YELLOW)
#define LCD_PINK   _rev(TFT_PINK)
#define LCD_PURPLE _rev(TFT_PURPLE)
#define LCD_MODE   _rev(0xf000)

namespace UTIL
{
  static const int16_t __not_in_flash("fast_access_sram") sin_tab[1024] =
  {
    (int16_t)32767,
    (int16_t)32766,
    (int16_t)32765,
    (int16_t)32761,
    (int16_t)32757,
    (int16_t)32752,
    (int16_t)32745,
    (int16_t)32737,
    (int16_t)32728,
    (int16_t)32717,
    (int16_t)32705,
    (int16_t)32692,
    (int16_t)32678,
    (int16_t)32663,
    (int16_t)32646,
    (int16_t)32628,
    (int16_t)32609,
    (int16_t)32589,
    (int16_t)32567,
    (int16_t)32545,
    (int16_t)32521,
    (int16_t)32495,
    (int16_t)32469,
    (int16_t)32441,
    (int16_t)32412,
    (int16_t)32382,
    (int16_t)32351,
    (int16_t)32318,
    (int16_t)32285,
    (int16_t)32250,
    (int16_t)32213,
    (int16_t)32176,
    (int16_t)32137,
    (int16_t)32098,
    (int16_t)32057,
    (int16_t)32014,
    (int16_t)31971,
    (int16_t)31926,
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
    (int16_t)31633,
    (int16_t)31685,
    (int16_t)31736,
    (int16_t)31785,
    (int16_t)31833,
    (int16_t)31880,
    (int16_t)31926,
    (int16_t)31971,
    (int16_t)32014,
    (int16_t)32057,
    (int16_t)32098,
    (int16_t)32137,
    (int16_t)32176,
    (int16_t)32213,
    (int16_t)32250,
    (int16_t)32285,
    (int16_t)32318,
    (int16_t)32351,
    (int16_t)32382,
    (int16_t)32412,
    (int16_t)32441,
    (int16_t)32469,
    (int16_t)32495,
    (int16_t)32521,
    (int16_t)32545,
    (int16_t)32567,
    (int16_t)32589,
    (int16_t)32609,
    (int16_t)32628,
    (int16_t)32646,
    (int16_t)32663,
    (int16_t)32678,
    (int16_t)32692,
    (int16_t)32705,
    (int16_t)32717,
    (int16_t)32728,
    (int16_t)32737,
    (int16_t)32745,
    (int16_t)32752,
    (int16_t)32757,
    (int16_t)32761,
    (int16_t)32765,
    (int16_t)32766
  };

  static const uint32_t __not_in_flash_func(map)(const uint32_t x,const uint32_t in_min, const uint32_t in_max,const uint32_t out_min, const float out_max)
  {
    // unsigned map
    if (x<in_min)
    {
      return out_min;
    }
    if (x>in_max)
    {
      return out_max;
    }
    return (x - in_min) * (out_max - out_min) / (in_max - in_min) + out_min;
  }

  static const uint32_t prng32(void)
  {
    volatile static uint32_t state = PRNG_SEED;
    uint32_t x = state;
    x ^= x << 13;
    x ^= x >> 17;
    x ^= x << 5;
    return (state = x);
  }

}
#endif
