ianm8/uSBITX/(commit log)

2024-11-08 Schematic V1.1
2024-11-08 RX/TX Filter
2024-11-19 bug fixes - see uSBITX.ino
    [dsp.h, spectrum.h, uSBITX.ino]
2025-02-11 Gerber File
2025-06-23 Schematic V1.2
