ianm8/uSBITX/docs/RX-TX-Filter.jpg

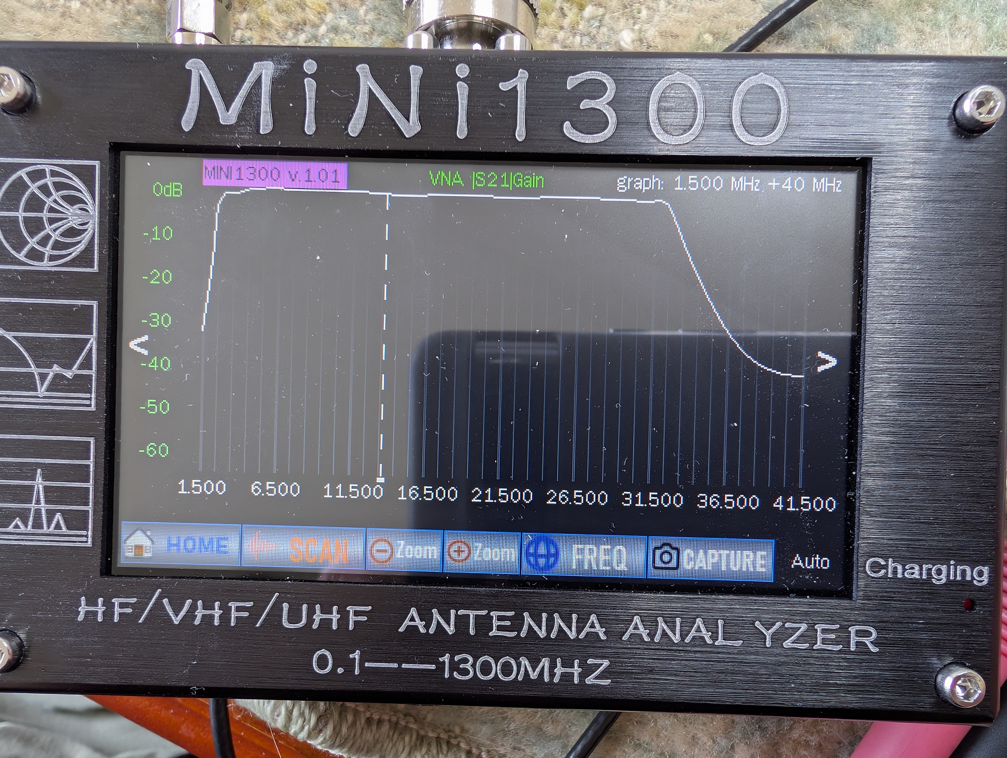
docs/RX-TX-Filter.jpg
